lukepalmer/wifi-switch/(commit log)

2017-11-27 Add arduino sketch
2017-11-28 add schematic
2017-11-28 Add board pictures
